Calvin390/MotoLogger/Moto_PCBs/Moto_Mobo/DataLogger2025.kicad_pcb

## KiCad design Moto_PCBs/Moto_Mobo/DataLogger2025.kicad_pcb (2026-07-17)

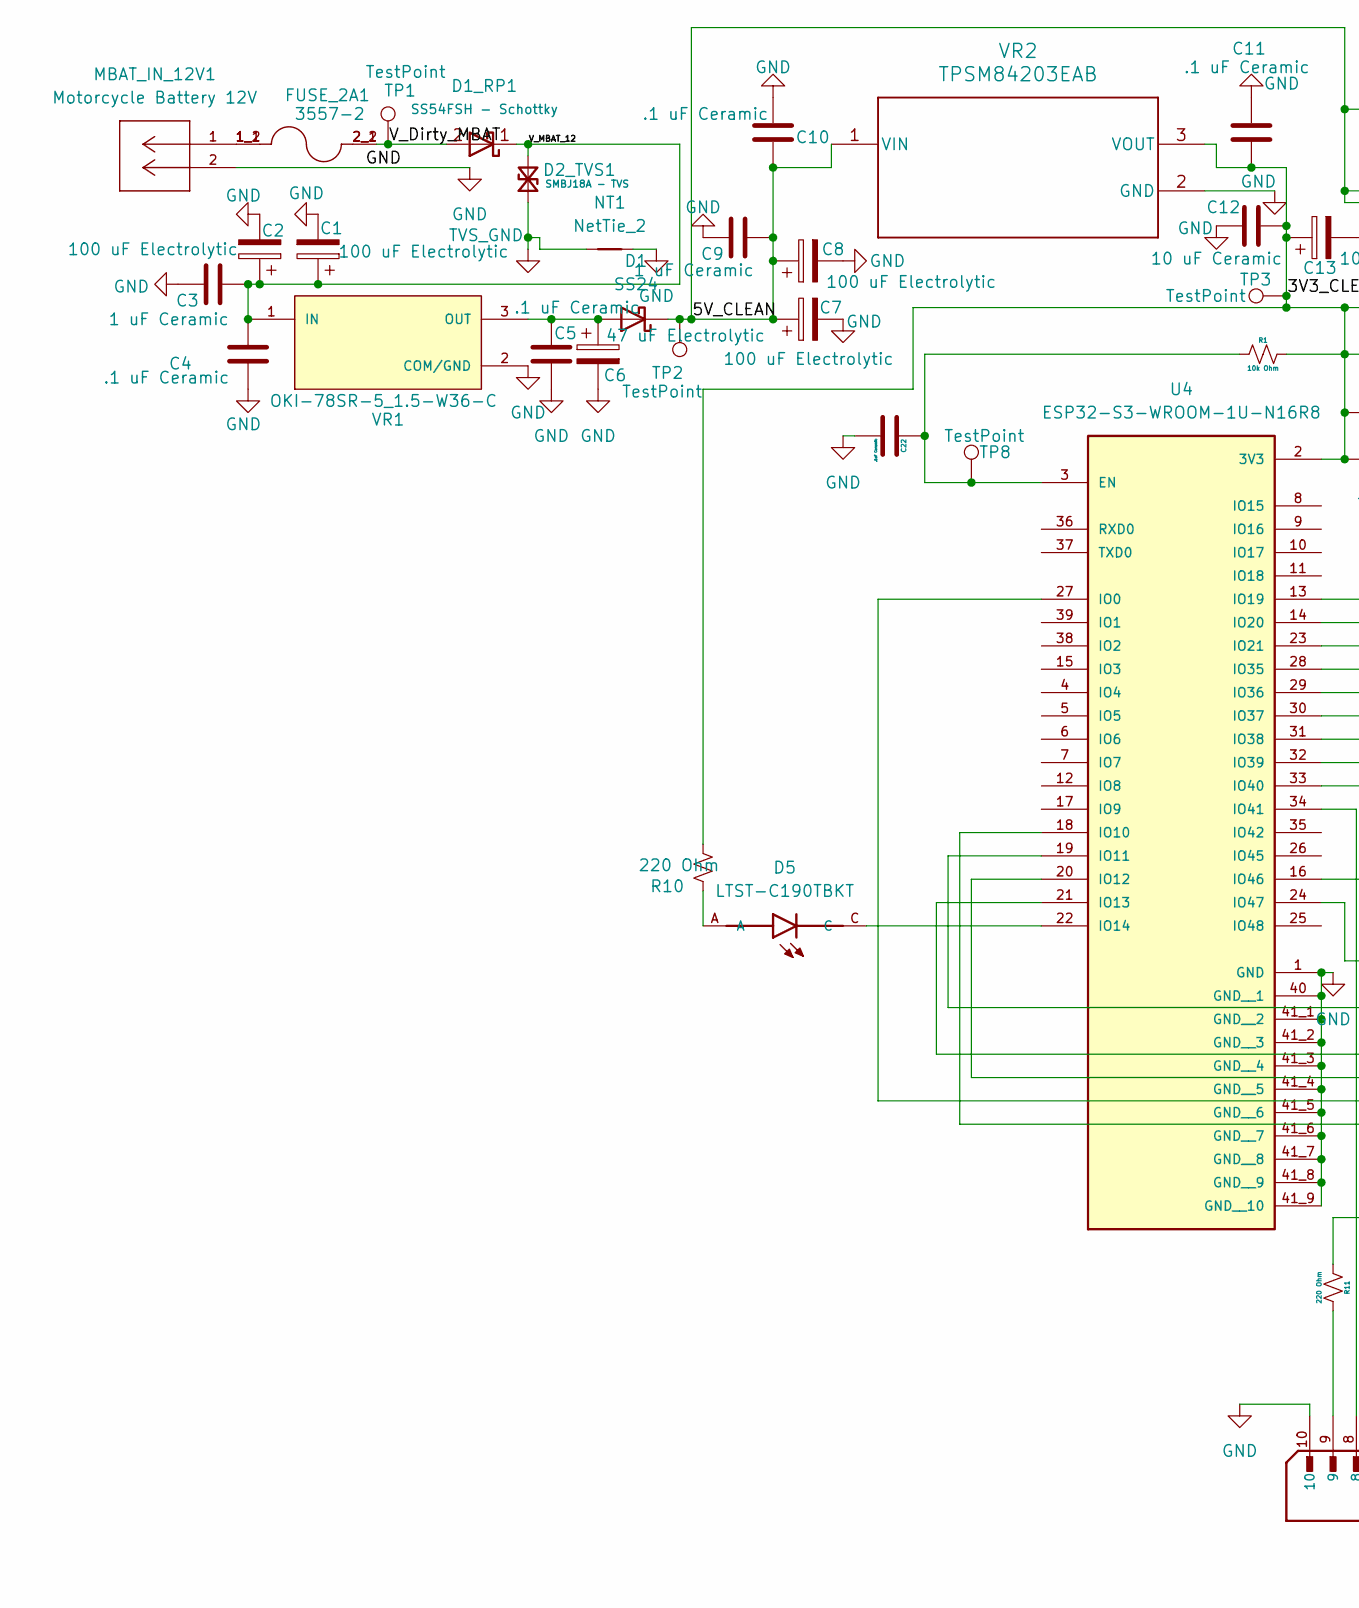
[picture p14: schematic DataLogger2025.kicad_sch, part in row 1, column 1]

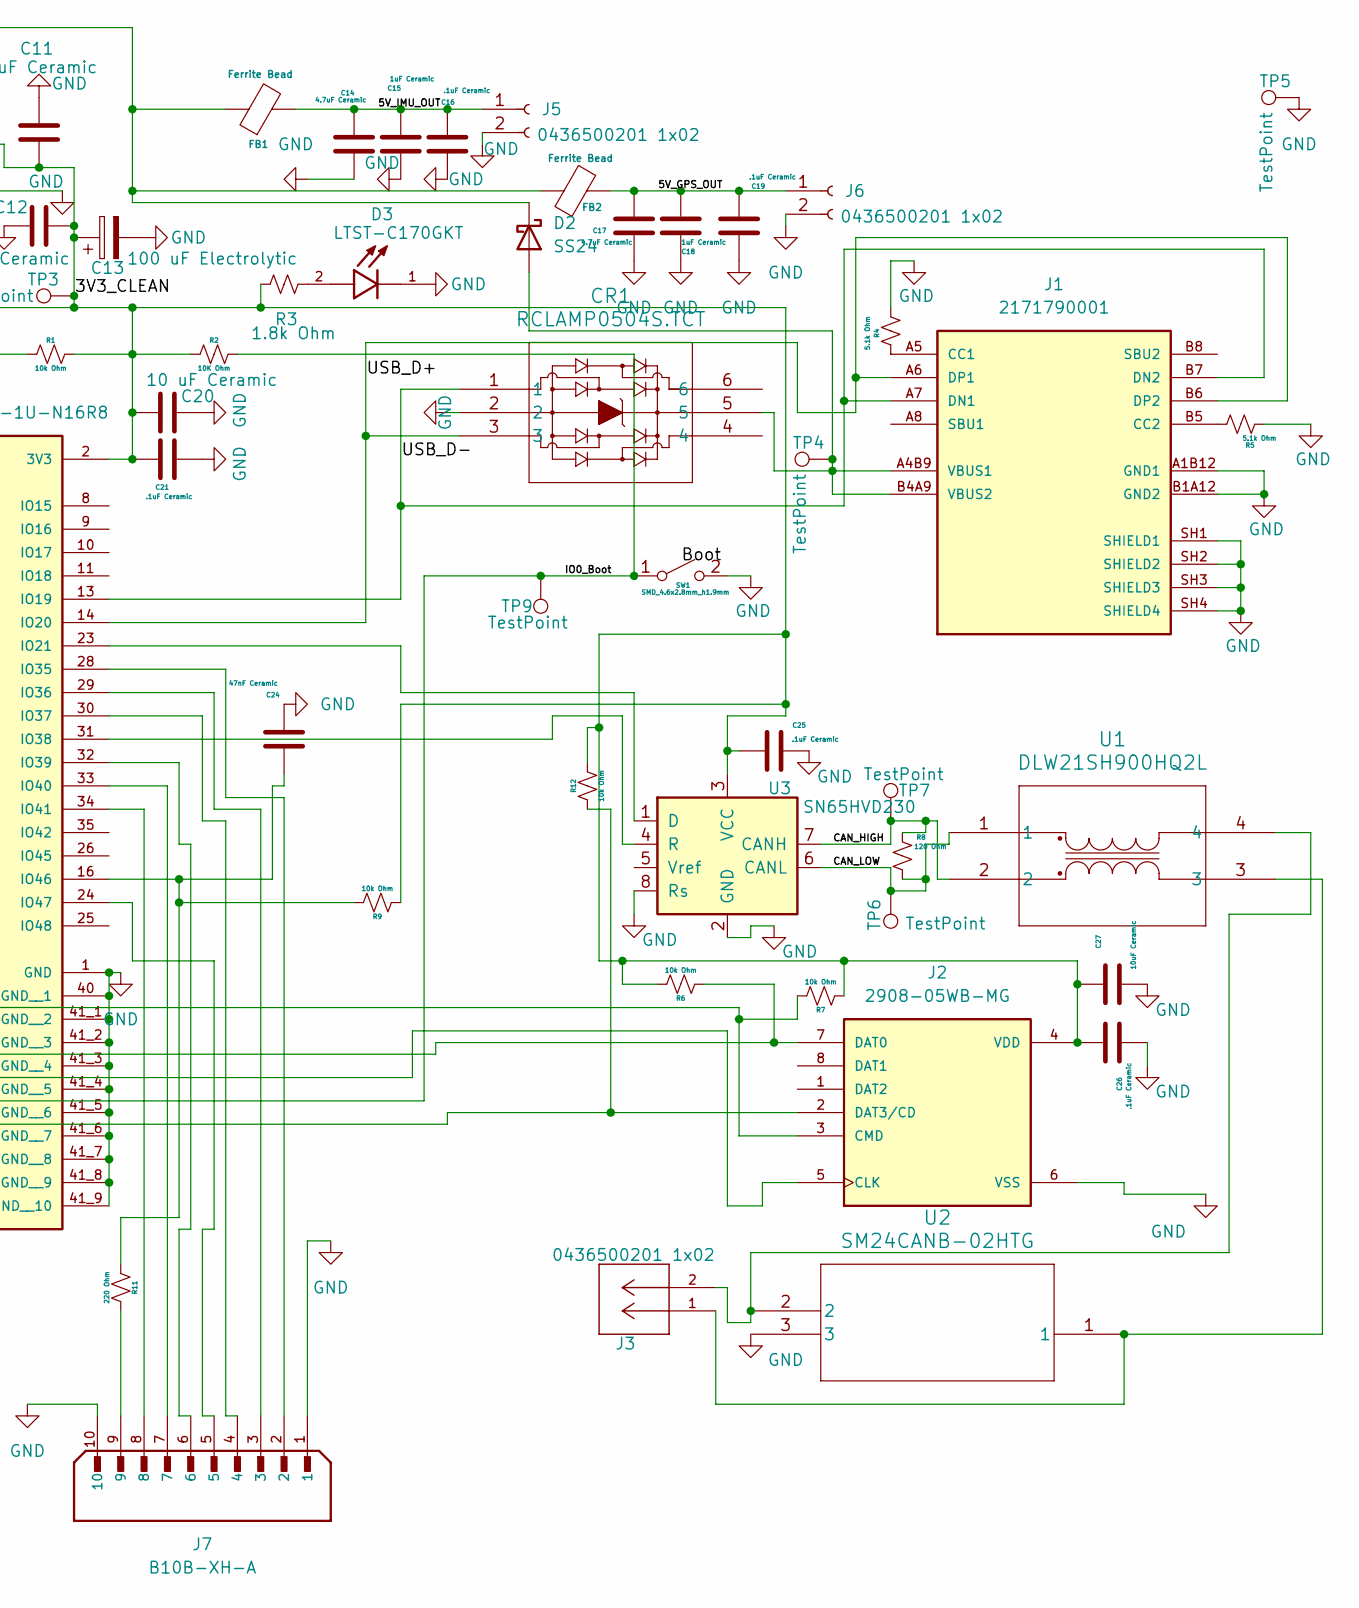
[picture p15: schematic DataLogger2025.kicad_sch, part in row 1, column 2]

Parts:
C1, C2, C7, C8, C13: 100 uF Electrolytic; CP_Radial_D8.0mm_P2.50mm
C3, C9: 1 uF Ceramic; C_1206_3216Metric_Pad1.33x1.80mm_HandSolder
C4, C5, C10, C11: .1 uF Ceramic; C_1206_3216Metric_Pad1.33x1.80mm_HandSolder
C6: 47 uF Electrolytic; CP_Radial_D6.3mm_P2.50mm
C12, C20: 10 uF Ceramic; C_1206_3216Metric_Pad1.33x1.80mm_HandSolder
C14, C17: 4.7uF Ceramic; C_1206_3216Metric_Pad1.33x1.80mm_HandSolder
C15, C18: 1uF Ceramic; C_1206_3216Metric_Pad1.33x1.80mm_HandSolder
C16, C19, C21, C22, C25, C26: .1uF Ceramic; C_1206_3216Metric_Pad1.33x1.80mm_HandSolder
C24: 47nF Ceramic; C_1206_3216Metric_Pad1.33x1.80mm_HandSolder
C27: 10uF Ceramic; C_1206_3216Metric_Pad1.33x1.80mm_HandSolder
CR1: RCLAMP0504S.TCT; SC70-6L_RCLAMP_1p75x3p1-0p95_SEM
D1, D2: SS24; SOD-123F_ONS
D1_RP1: SS54FSH - Schottky; D_SMB
D2_TVS1: SMBJ18A - TVS; D_SMB_Handsoldering
D3: LTST-C170GKT; LED_LTST-C170GKT; PARTREV I; DigiKey_Part_Number 160-1179-1-ND
D5: LTST-C190TBKT; LEDM1608X80; DigiKey_Part_Number 160-1646-1-ND
FB1, FB2: Ferrite Bead; L_1206_3216Metric_Pad1.42x1.75mm_HandSolder
FUSE_2A1: 3557-2; FUSE_3557-2; PARTREV D; DigiKey_Part_Number 36-3557-2-ND
J1: 2171790001; MOLEX_2171790001; PARTREV A1; DigiKey_Part_Number 900-2171790001CT-ND
J2: 2908-05WB-MG; 3M_2908-05WB-MG; DigiKey_Part_Number 3M5607CT-ND
J3: 0436500201 1x02; CONN_SD-43650-001_02_MOL; MANUFACTURER_PART_NUMBER 436500201
J5, J6: 0436500201 1x02; Molex_Micro-Fit_3.0_43650-0200_1x02_P3.00mm_Horizontal
J7: B10B-XH-A; JST_B10B-XH-A; PARTREV 7/4/21; DigiKey_Part_Number 455-B10B-XH-A-ND
MBAT_IN_12V1: Motorcycle Battery 12V; CONN_SD-43650-001_02_MOL; MANUFACTURER_PART_NUMBER 436500201
NT1: NetTie_2; NetTie-2_SMD_Pad0.5mm
R1, R6, R7, R9, R12: 10k Ohm; R_1206_3216Metric_Pad1.30x1.75mm_HandSolder
R2: 10K Ohm; R_1206_3216Metric_Pad1.30x1.75mm_HandSolder
R3: 1.8k Ohm; R_1206_3216Metric_Pad1.30x1.75mm_HandSolder
R4, R5: 5.1k Ohm; R_1206_3216Metric_Pad1.30x1.75mm_HandSolder
R8: 120 Ohm; R_Axial_DIN0204_L3.6mm_D1.6mm_P5.08mm_Horizontal
R10, R11: 220 Ohm; R_1206_3216Metric_Pad1.30x1.75mm_HandSolder
SW1: SMD_4.6x2.8mm_h1.9mm; Push_SMD_4.6x2.8mm_h1.9mm
TP1, TP2, TP3, TP4, TP5, TP6, TP7, TP9: TestPoint; TestPoint_Pad_1.5x1.5mm
TP8: TestPoint; TestPoint_Pad_1.0x1.0mm
U1: DLW21SH900HQ2L; DLW21SH_MUR
U2: SM24CANB-02HTG; SOT23-3_SM24CANB-02HTG_LTF
U3: SN65HVD230; SOIC-8_3.9x4.9mm_P1.27mm
U4: ESP32-S3-WROOM-1U-N16R8; XCVR_ESP32-S3-WROOM-1U-N16R8; PARTREV v1.1; DigiKey_Part_Number 1965-ESP32-S3-WROOM-1U-N16R8CT-ND
VR1: OKI-78SR-5_1.5-W36-C; CONV_OKI-78SR-5_1.5-W36-C; PARTREV N/A; DigiKey_Part_Number 811-2196-5-ND
VR2: TPSM84203EAB; EAB0003A

Connections:
/3V3_CLEAN: C11.2, C12.2, C13.1, C20.2, C21.1, C25.1, C26.1, C27.1, J2.4 (VDD), R1.1, R2.2, R3.1, R6.1, R7.2, R9.2, R10.1, R12.1, TP3.1 (1_1), U3.3 (VCC), U4.2 (3V3), VR2.3 (VOUT)
/5V_CLEAN: C7.1, C8.1, C9.2, C10.2, D1.1 (K), D2.1 (K), FB1.1, FB2.1, TP2.1 (1_1), VR2.1 (VIN)
/5V_GPS_OUT: C17.1, C18.1, C19.1, FB2.2, J6.1
/5V_IMU_OUT: C14.1, C15.1, C16.1, FB1.2, J5.1
/CAN_HIGH: R8.2, TP7.1 (1_1), U1.2, U3.7 (CANH)
/CAN_LOW: R8.1, TP6.1 (1_1), U1.1, U3.6 (CANL)
/IO0_Boot: R2.1, SW1.1 (A), TP9.1 (1_1), U4.27 (IO0)
/USB_D+: CR1.3, J1.A6 (DP1), J1.B6 (DP2), U4.14 (IO20)
/USB_D-: CR1.1, J1.A7 (DN1), J1.B7 (DN2), U4.13 (IO19)
/V_Dirty_MBAT: D1_RP1.2 (A), FUSE_2A1.2_1, FUSE_2A1.2_2, TP1.1 (1_1)
/V_MBAT_12: C1.1, C2.1, C3.2, C4.2, D1_RP1.1 (K), D2_TVS1.2 (A2), VR1.1 (IN)
GND: C1.2, C2.2, C3.1, C4.1, C5.1, C6.2, C7.2, C8.2, C9.1, C10.1, C11.1, C12.1, C13.2, C14.2, C15.2, C16.2, C17.2, C18.2, C19.2, C20.1, C21.2, C22.2, C24.1, C25.2, C26.2, C27.2, CR1.2, D3.1, J1.A1B12 (GND1), J1.B1A12 (GND2), J1.SH1 (SHIELD1), J1.SH2 (SHIELD2), J1.SH3 (SHIELD3), J1.SH4 (SHIELD4), J2.6 (VSS), J5.2, J6.2, J7.1, J7.10, MBAT_IN_12V1.2, NT1.2, R4.1, R5.1, SW1.2 (B), TP5.1 (1_1), U2.3, U3.2 (GND), U3.8 (Rs), U4.1 (GND), U4.40 (GND__1), U4.41_1 (GND__2), U4.41_2 (GND__3), U4.41_3 (GND__4), U4.41_4 (GND__5), U4.41_5 (GND__6), U4.41_6 (GND__7), U4.41_7 (GND__8), U4.41_8 (GND__9), U4.41_9 (GND__10), VR1.2 (COM/GND), VR2.2 (GND)
unnamed: C5.2, C6.1, D1.2 (A), VR1.3 (OUT)
unnamed: CR1.5, D2.2 (A), J1.A4B9 (VBUS1), J1.B4A9 (VBUS2), TP4.1 (1_1)
unnamed: D3.2, R3.2
unnamed: D5.A, R10.2
unnamed: FUSE_2A1.1_1, FUSE_2A1.1_2, MBAT_IN_12V1.1
unnamed: J1.A5 (CC1), R4.2
unnamed: J1.B5 (CC2), R5.2
unnamed: J2.5 (CLK), U4.20 (IO12)
unnamed: J2.3 (CMD), R7.1, U4.19 (IO11)
unnamed: J2.7 (DAT0), R6.2, U4.21 (IO13)
unnamed: J2.2 (DAT3/CD), R12.2, U4.18 (IO10)
unnamed: J3.1, U1.3, U2.1
unnamed: J3.2, U1.4, U2.2
unnamed: J7.9, R11.1
unnamed: U3.1 (D), U4.23 (IO21)
unnamed: U3.4 (R), U4.31 (IO38)
unnamed: C22.1, R1.2, TP8.1 (1_1), U4.3 (EN)
unnamed: D5.C, U4.22 (IO14)
unnamed: J7.2, U4.28 (IO35)
unnamed: J7.3, U4.29 (IO36)
unnamed: J7.4, U4.30 (IO37)
unnamed: J7.6, U4.32 (IO39)
unnamed: J7.7, U4.33 (IO40)
unnamed: J7.8, U4.34 (IO41)
unnamed: C24.2, R9.1, R11.2, U4.16 (IO46)
unnamed: J7.5, U4.24 (IO47)
TVS_GND: D2_TVS1.1 (A1), NT1.1

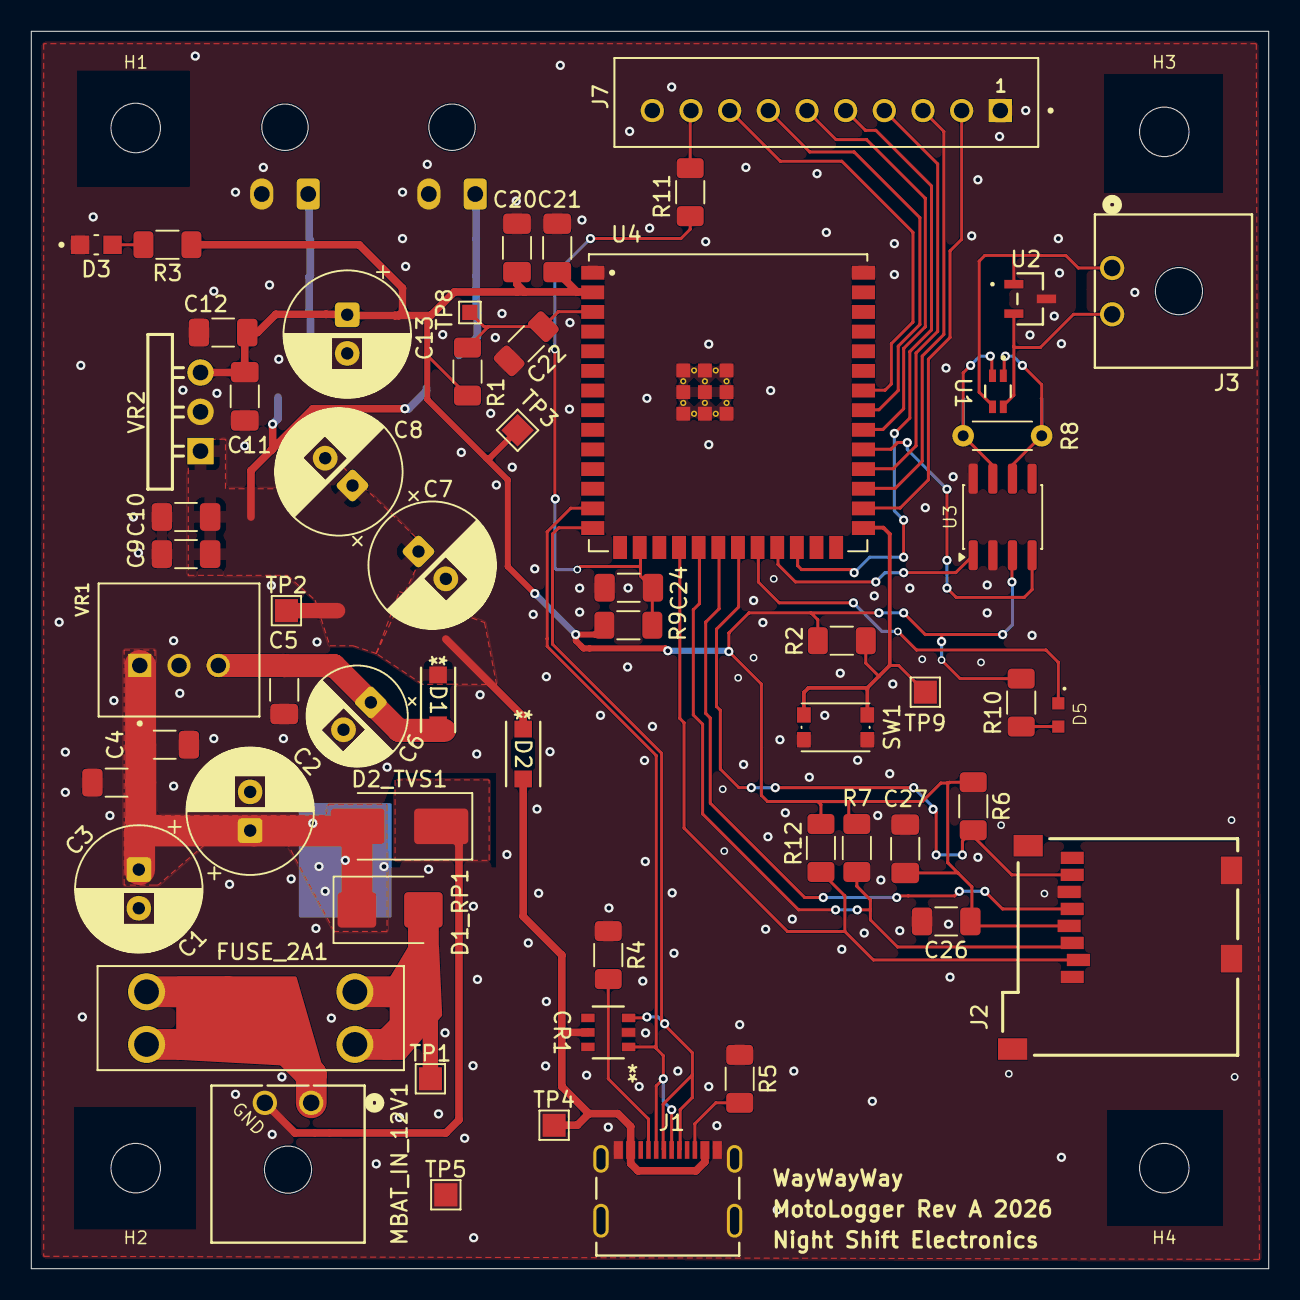
[picture p16: board DataLogger2025.kicad_pcb from above]

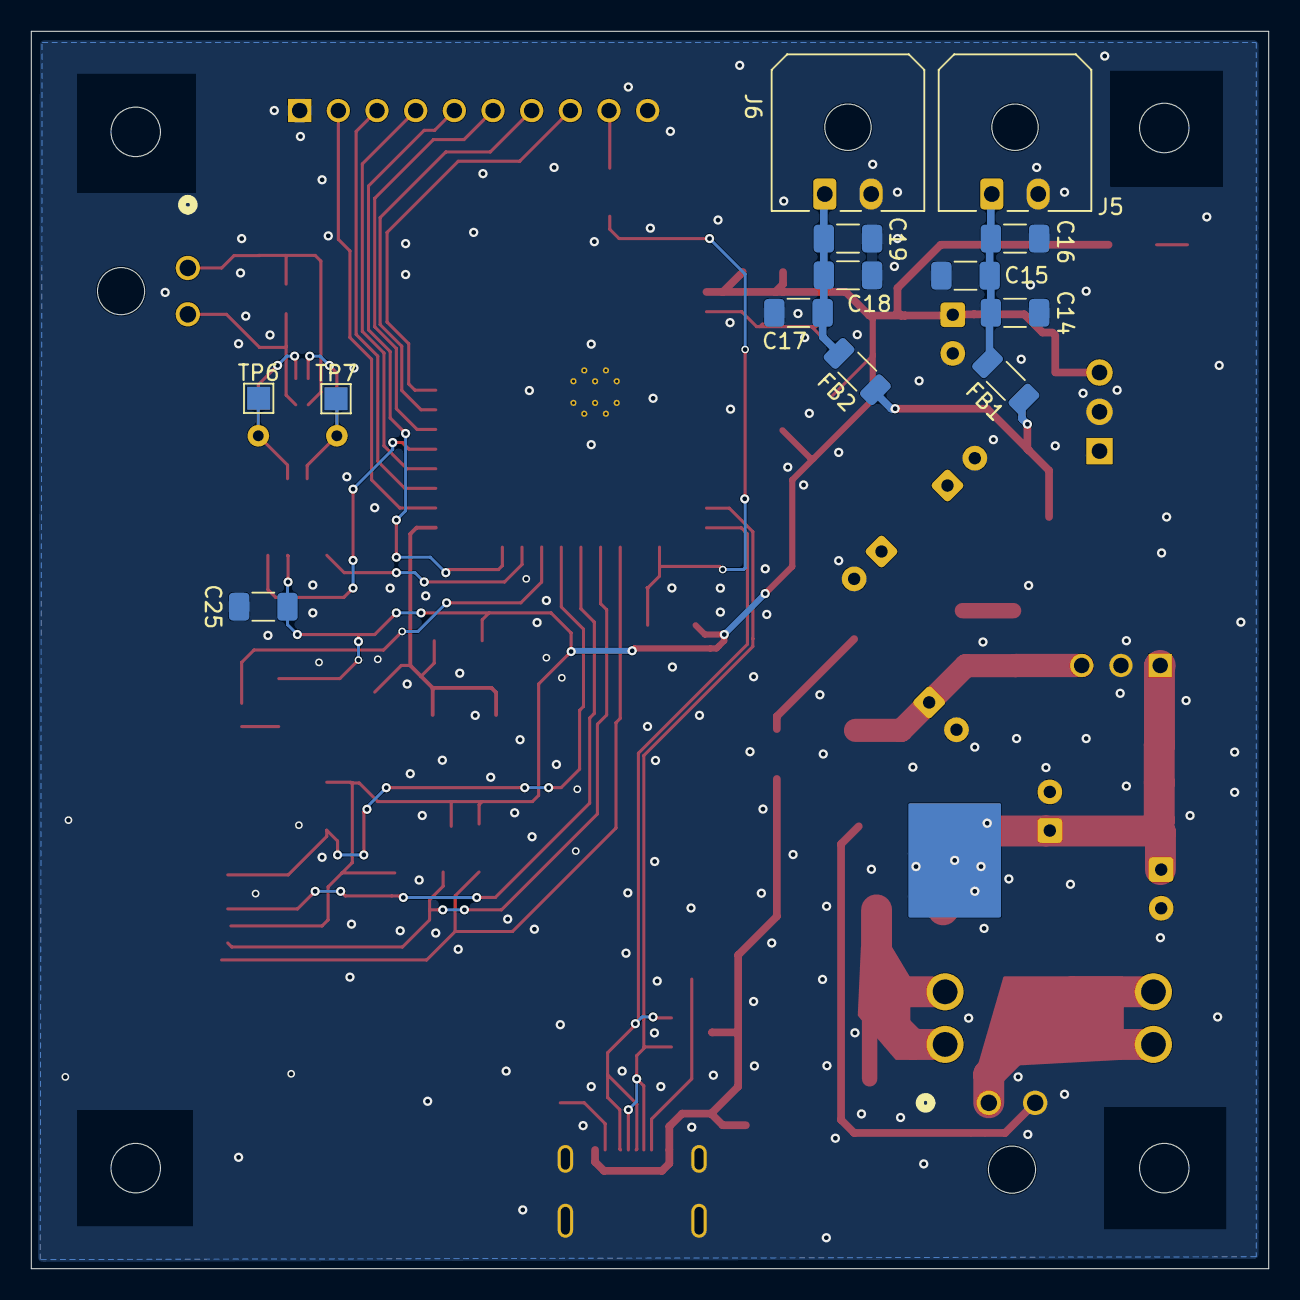
[picture p17: board DataLogger2025.kicad_pcb from below]

Board: 2 copper layers, 80.0 x 80.0 mm, 76 parts (13 on the bottom side), 39 nets.

Other parts of the board:
H1, H2, H3, H4: MountingHole; MountingHole_3.2mm_M3
