Calvin390/MotoLogger/Moto_PCBs/Moto_IMU/IMU_DB.kicad_pcb

## KiCad design Moto_PCBs/Moto_IMU/IMU_DB.kicad_pcb (2026-07-02)

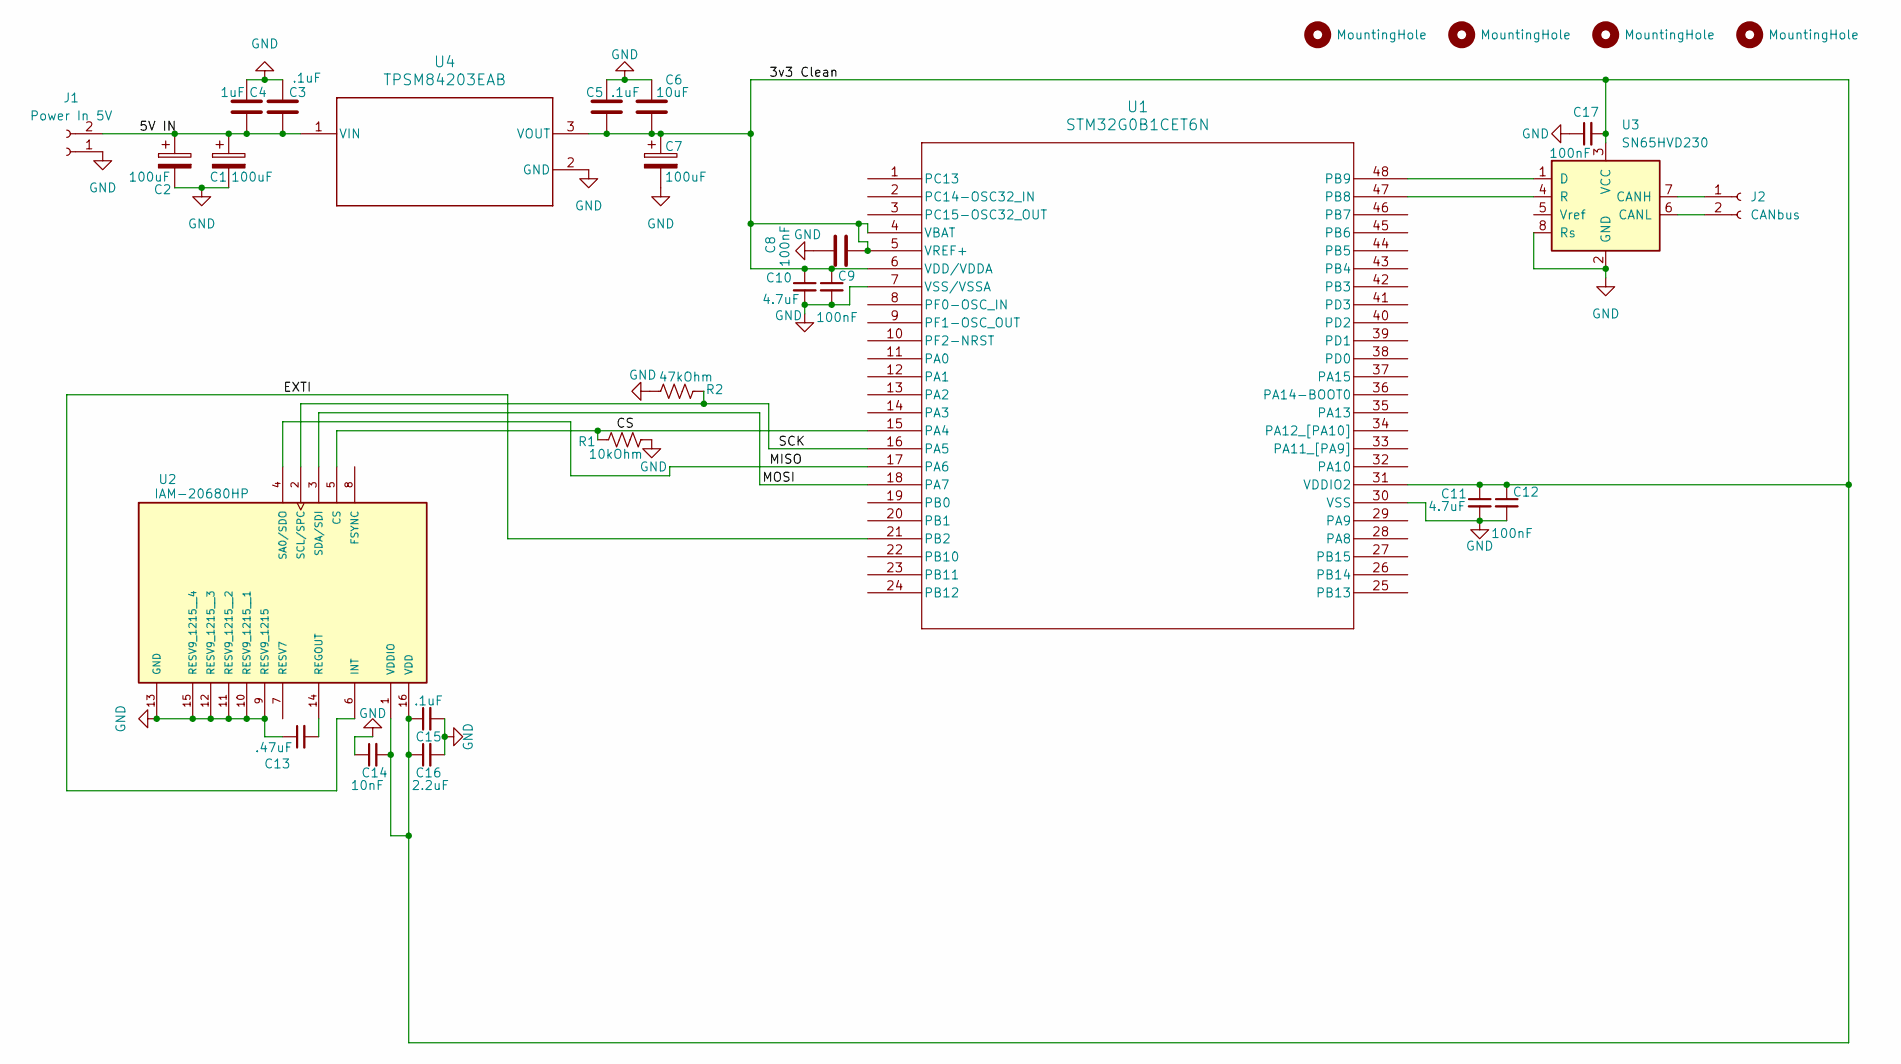
[picture p18: schematic IMU_DB.kicad_sch]

Parts:
C1, C2, C7: 100uF; CP_Radial_D5.0mm_P2.50mm
C3, C5, C15: .1uF; C_0805_2012Metric_Pad1.18x1.45mm_HandSolder
C4: 1uF; C_0805_2012Metric_Pad1.18x1.45mm_HandSolder
C6: 10uF; C_0805_2012Metric_Pad1.18x1.45mm_HandSolder
C8, C9, C12, C17: 100nF; C_0805_2012Metric_Pad1.18x1.45mm_HandSolder
C10, C11: 4.7uF; C_0805_2012Metric_Pad1.18x1.45mm_HandSolder
C13: .47uF; C_0805_2012Metric_Pad1.18x1.45mm_HandSolder
C14: 10nF; C_0805_2012Metric_Pad1.18x1.45mm_HandSolder
C16: 2.2uF; C_0805_2012Metric_Pad1.18x1.45mm_HandSolder
H1, H2, H3, H4: MountingHole; MountingHole_2.2mm_M2
J1: Power In 5V; CONN_SD-43650-001_02_MOL
J2: CANbus; CONN_SD-43650-001_02_MOL
R1: 10kOhm; R_0805_2012Metric_Pad1.20x1.40mm_HandSolder
R2: 47kOhm; R_0805_2012Metric_Pad1.20x1.40mm_HandSolder
U1: STM32G0B1CET6N; LQFP48_STM
U2: IAM-20680HP; PQFN50P300X300X80-16N
U3: SN65HVD230; SOIC-8_3.9x4.9mm_P1.27mm
U4: TPSM84203EAB; EAB0003A

Connections:
/3v3 Clean: C5.2, C6.2, C7.1, C8.2, C9.1, C10.1, C11.1, C12.1, C14.2, C15.1, C16.1, C17.2, U1.4 (VBAT), U1.5 (VREF+), U1.6 (VDD/VDDA), U1.31 (VDDIO2), U2.1 (VDDIO), U2.16 (VDD), U3.3 (VCC), U4.3 (VOUT)
/5V IN: C1.1, C2.1, C3.2, C4.2, J1.2, U4.1 (VIN)
/CS: R1.1, U1.15 (PA4), U2.5 (CS)
/EXTI: U1.21 (PB2), U2.6 (INT)
/MISO: U1.17 (PA6), U2.4 (SA0/SDO)
/MOSI: U1.18 (PA7), U2.3 (SDA/SDI)
/SCK: R2.1, U1.16 (PA5), U2.2 (SCL/SPC)
GND: C1.2, C2.2, C3.1, C4.1, C5.1, C6.1, C7.2, C8.1, C9.2, C10.2, C11.2, C12.2, C13.1, C14.1, C15.2, C16.2, C17.1, J1.1, R1.2, R2.2, U1.7 (VSS/VSSA), U1.30 (VSS), U2.9 (RESV9_1215), U2.10 (RESV9_1215__1), U2.11 (RESV9_1215__2), U2.12 (RESV9_1215__3), U2.13 (GND), U2.15 (RESV9_1215__4), U3.2 (GND), U3.8 (Rs), U4.2 (GND)
unnamed: J2.1, U3.7 (CANH)
unnamed: J2.2, U3.6 (CANL)
unnamed: U1.47 (PB8), U3.4 (R)
unnamed: U1.48 (PB9), U3.1 (D)
unnamed: C13.2, U2.14 (REGOUT)

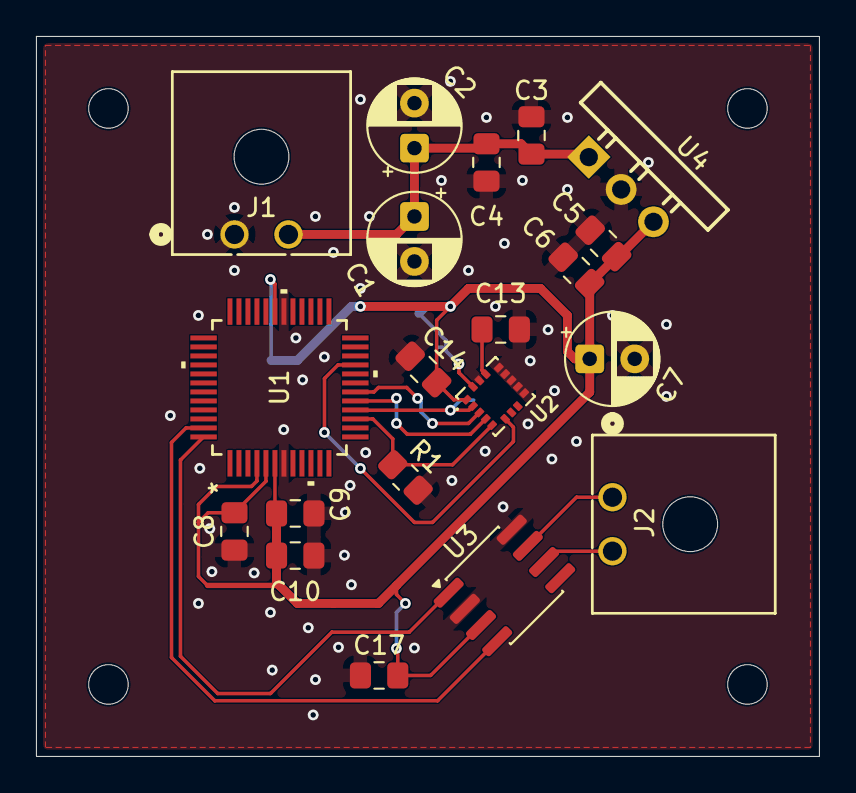
[picture p19: board IMU_DB.kicad_pcb from above]

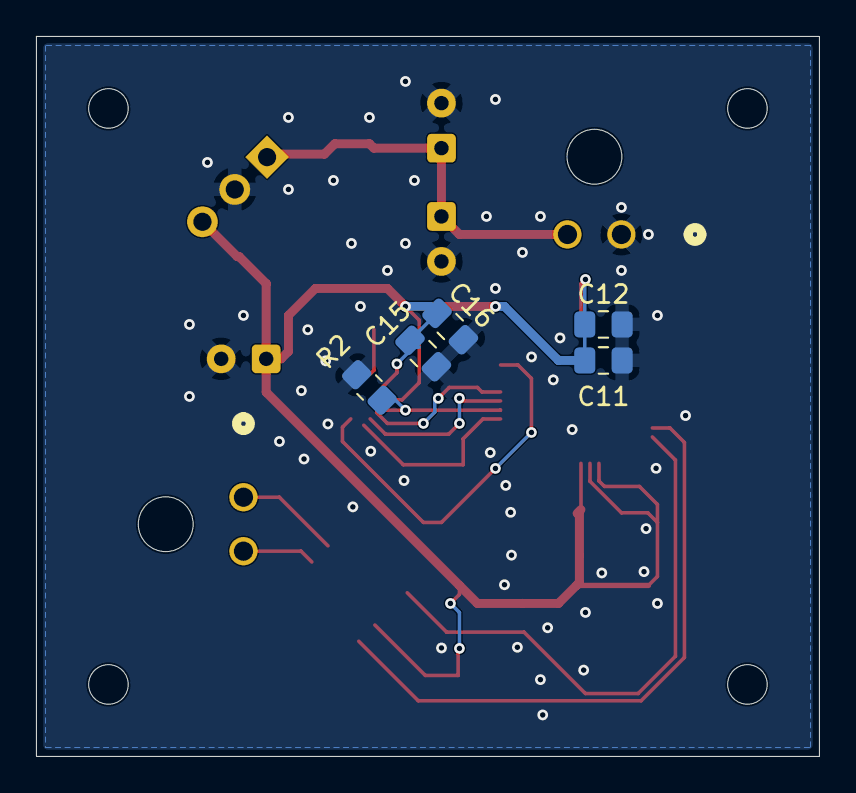
[picture p20: board IMU_DB.kicad_pcb from below]

Board: 2 copper layers, 43.5 x 40.0 mm, 29 parts (5 on the bottom side), 13 nets.
