Calvin390/MotoLogger/(commit log)

2026-06-29 PCB File readjustment
    [DataLogger2025-B_Adhesive.gbr, DataLogger2025-B_Cu.gbr, DataLogger2025-B_Mask.gbr, DataLogger2025-B_Paste.gbr, DataLogger2025-B_Silkscreen.gbr, DataLogger2025-F_Adhesive.gbr, DataLogger2025-F_Cu.gbr, DataLogger2025-F_Mask.gbr]
2026-06-30 Final Mobo GBR/PCB Files before PCBWAY Order
    [DataLogger2025-B_Adhesive.gbr, DataLogger2025-B_Cu.gbr, DataLogger2025-B_Mask.gbr, DataLogger2025-B_Paste.gbr, DataLogger2025-B_Silkscreen.gbr, DataLogger2025-F_Adhesive.gbr, DataLogger2025-F_Cu.gbr, DataLogger2025-F_Mask.gbr]
2026-07-02 IMU_STM C code Folder
2026-07-17 Remove Old GBR files
    [DataLogger2025-B_Adhesive.gbr, DataLogger2025-B_Cu.gbr, DataLogger2025-B_Mask.gbr, DataLogger2025-B_Paste.gbr, DataLogger2025-B_Silkscreen.gbr, DataLogger2025-F_Adhesive.gbr, DataLogger2025-F_Cu.gbr, DataLogger2025-F_Mask.gbr]
2026-07-24 Revise README with current status and firmware details
    Updated project status and firmware target details in README.
2026-07-24 Revise README with prototype and system info
    Updated hardware prototype details and system overview.
2026-08-13 Revise current status of PCB assembly and firmware
    Updated project status and details regarding PCB assembly and firmware flashing.
2026-08-27 add pcb bringup images
2026-08-27 Update README with image of Rev A board
    Added image of Rev A board with UART pins.
2026-08-27 Replace images in README with new prototypes
    Updated images in README to reflect current prototype.
