Calvin390/MotoLogger/projectImages/IMG_2569.jpeg

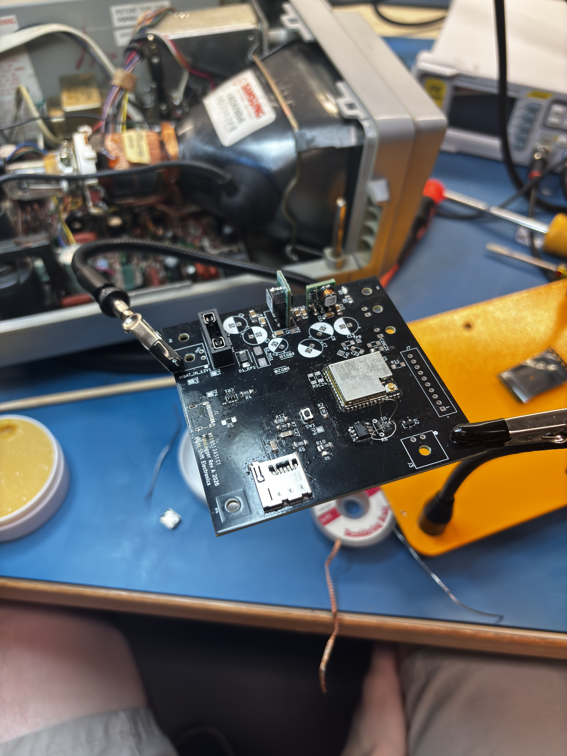
projectImages/IMG_2569.jpeg
