Calvin390/MotoLogger/projectImages/IMG_2570.jpeg

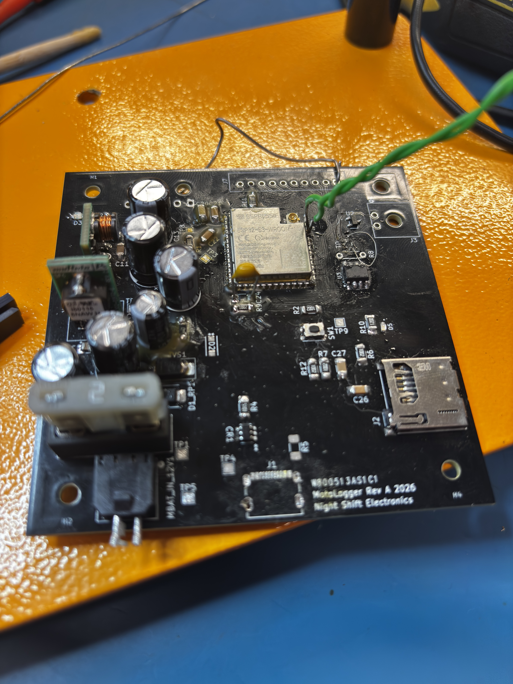
[picture p2: projectImages/IMG_2570.jpeg]
projectImages/IMG_2570.jpeg
