Calvin390/MotoLogger/projectImages/IMG_2573.jpeg

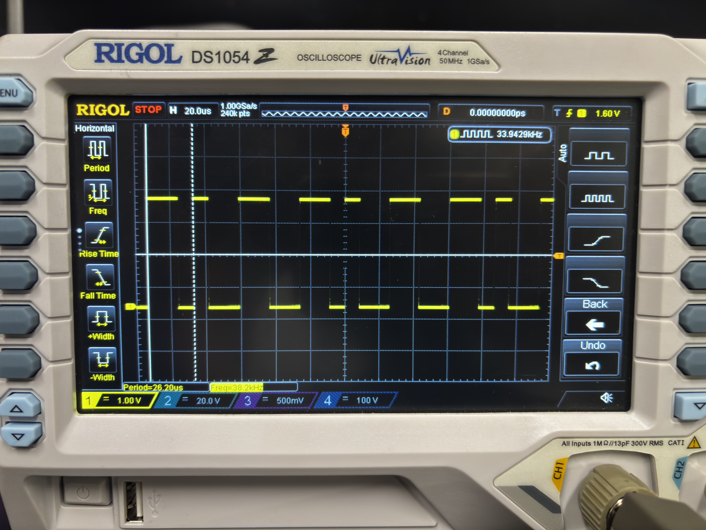
[picture p3: projectImages/IMG_2573.jpeg]
projectImages/IMG_2573.jpeg
